jimenezjose/Xbox360_RC_Car/(commit log)

2018-07-27 style - and failure safety
    [Controller.h, Xbox360_RC_Car.ino]
2018-07-27 style - and failure safetys
    [Controller.ino]
2018-07-31 Arduino code seperation
2018-07-31 program flow
2018-07-31 diagram flow
2018-09-10 decrease steering voltage via pwm
